Silent-Dripper/silent-dripper-electrical/media/oshpark-preview-back.png

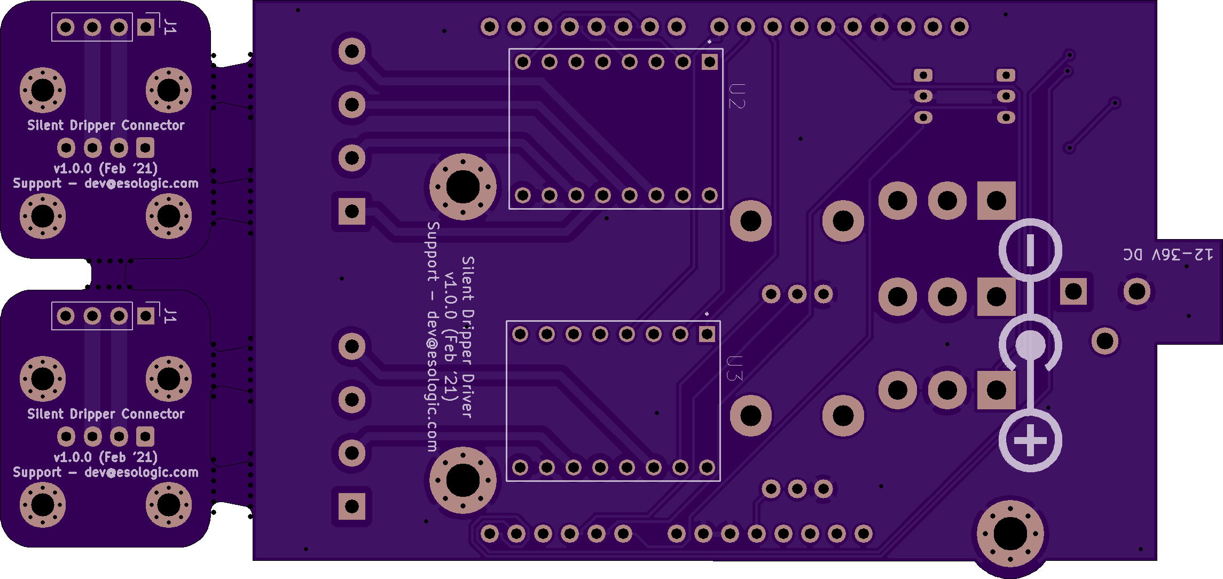
media/oshpark-preview-back.png
