Silent-Dripper/silent-dripper-electrical/media/oshpark-preview-front.png

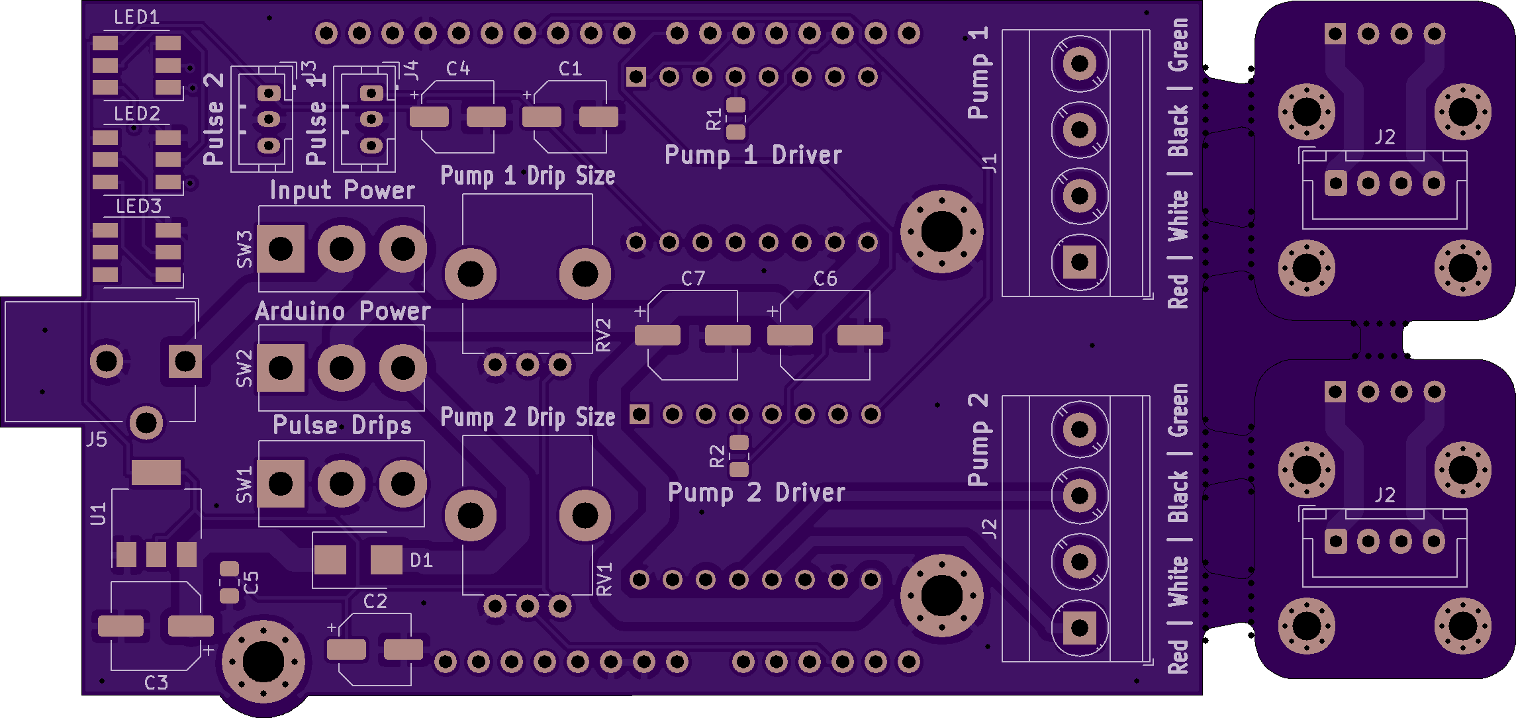
media/oshpark-preview-front.png
