Silent-Dripper/silent-dripper-electrical/panelized/dripper-gerbers/dripper-gerbers_Combined_Bottom.png

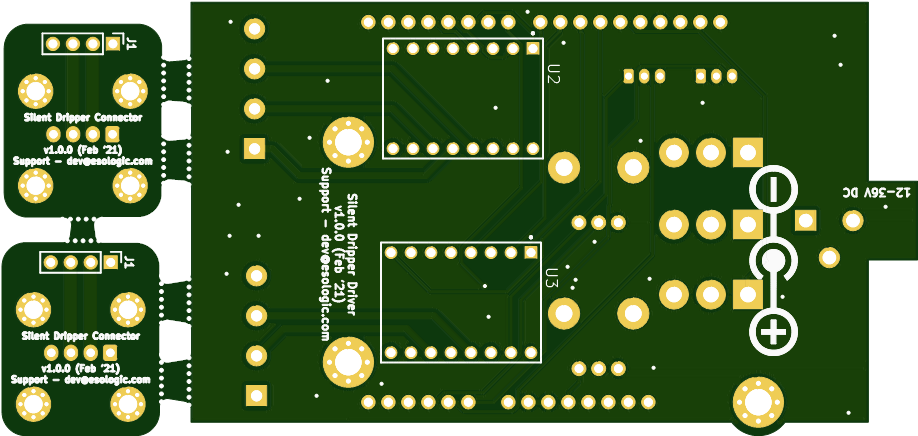
panelized/dripper-gerbers/dripper-gerbers_Combined_Bottom.png
