Silent-Dripper/silent-dripper-electrical/panelized/dripper-gerbers/dripper-gerbers_Combined_Top.png

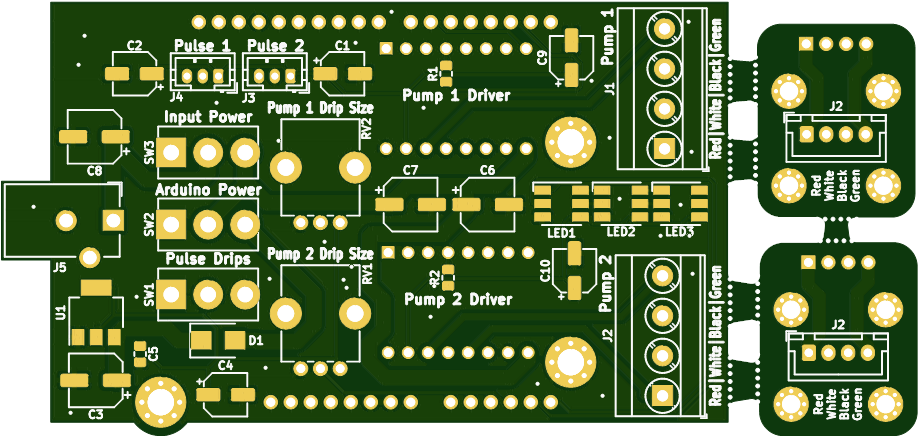
panelized/dripper-gerbers/dripper-gerbers_Combined_Top.png
