Silent-Dripper/silent-dripper-electrical/connector/connector-pcb-component-locations.DXF

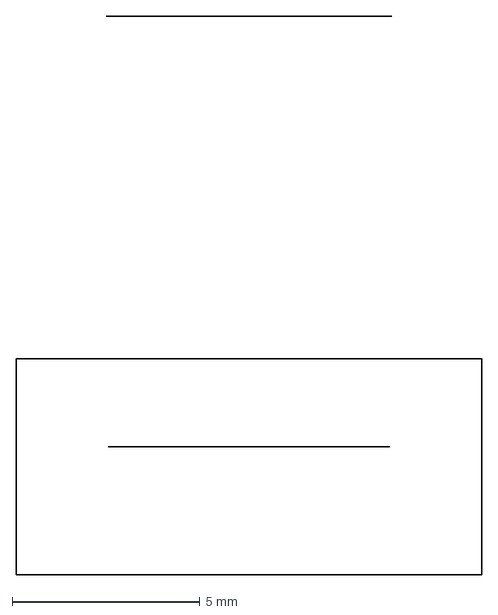
[picture p5: CAD file, 2021-11-12]
connector/connector-pcb-component-locations.DXF
12.4 x 14.9 mm
