Silent-Dripper/silent-dripper-electrical/connector/connector-pcb-outside-edge.DXF

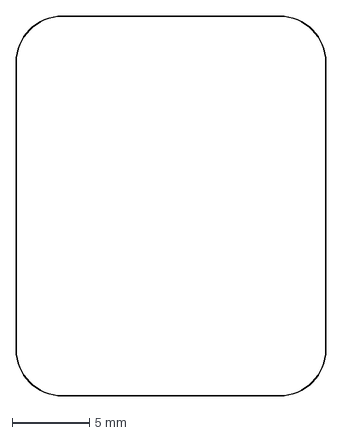
[picture p6: CAD file, 2021-11-12]
connector/connector-pcb-outside-edge.DXF
20.0 x 24.5 mm
