Silent-Dripper/silent-dripper-electrical/connector/connector-pcb-hole-locations.DXF

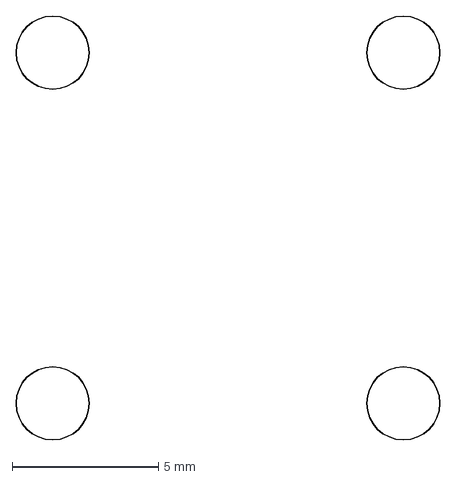
[picture p7: CAD file, 2021-11-12]
connector/connector-pcb-hole-locations.DXF
14.5 x 14.5 mm
