Silent-Dripper/silent-dripper-electrical/connector/connector-fit-check.pdf

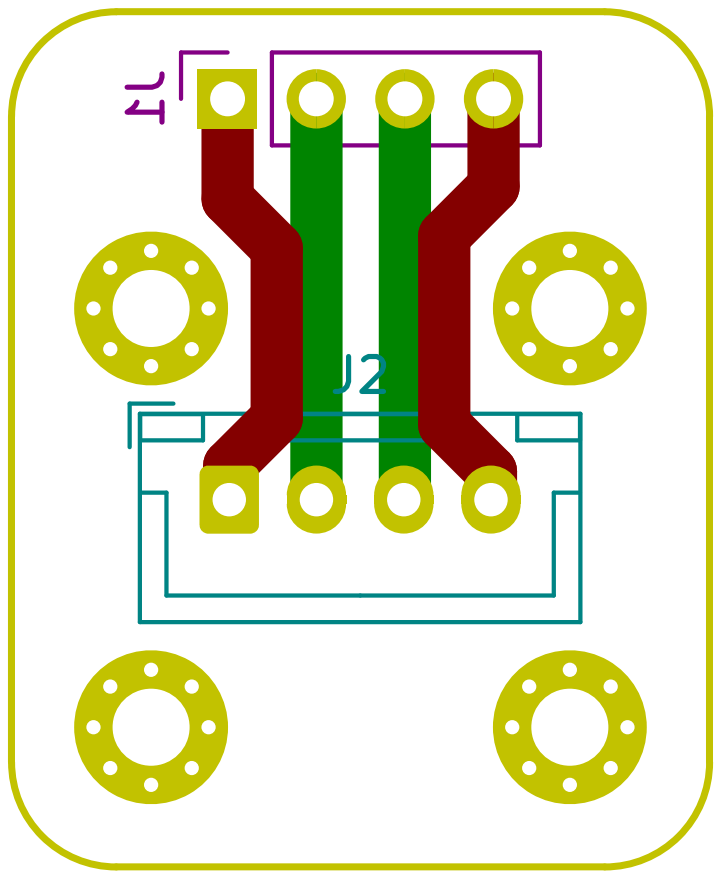
[picture p8: page 1]
