Silent-Dripper/silent-dripper-electrical/driver/driver-fit-check-back.pdf

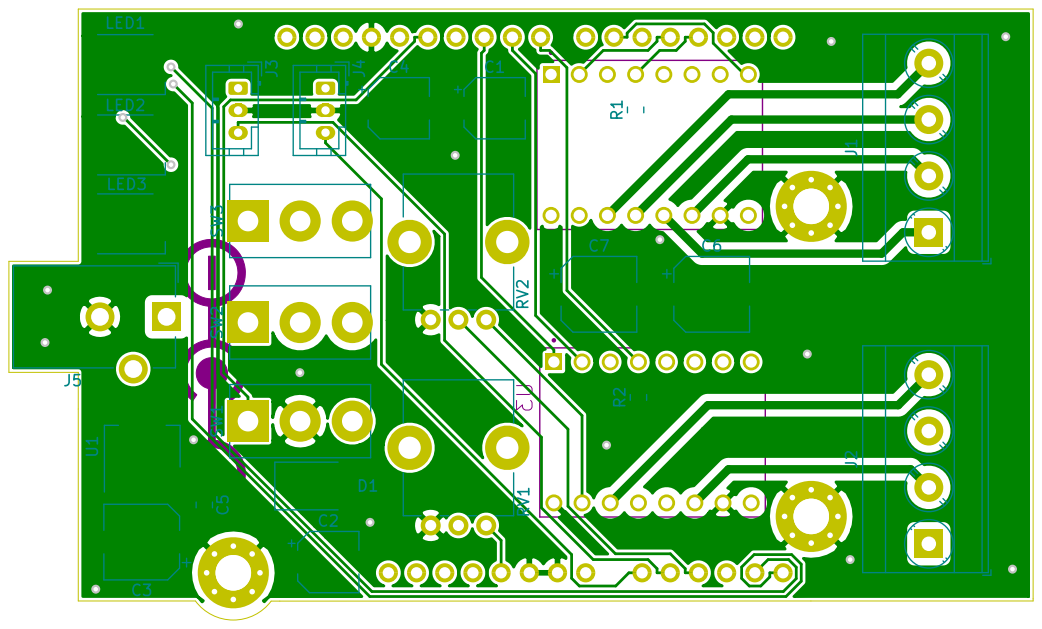
[picture p9: page 1]
