Silent-Dripper/silent-dripper-electrical/driver/driver-fit-check-front.pdf

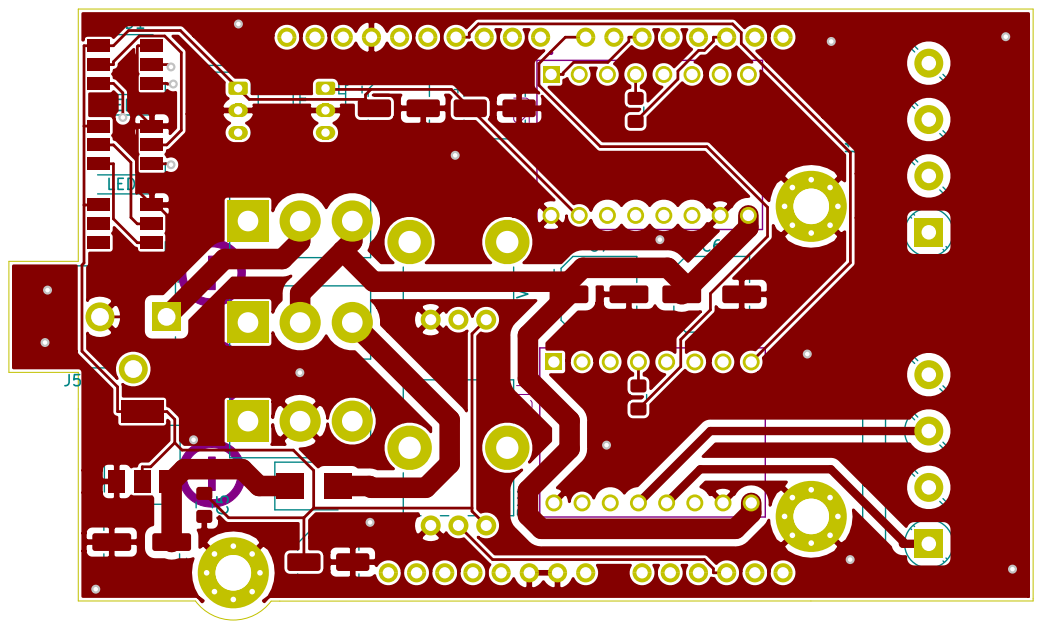
[picture p10: page 1]
