Silent-Dripper/silent-dripper-electrical/driver/driver-fit-check-no-copper.pdf

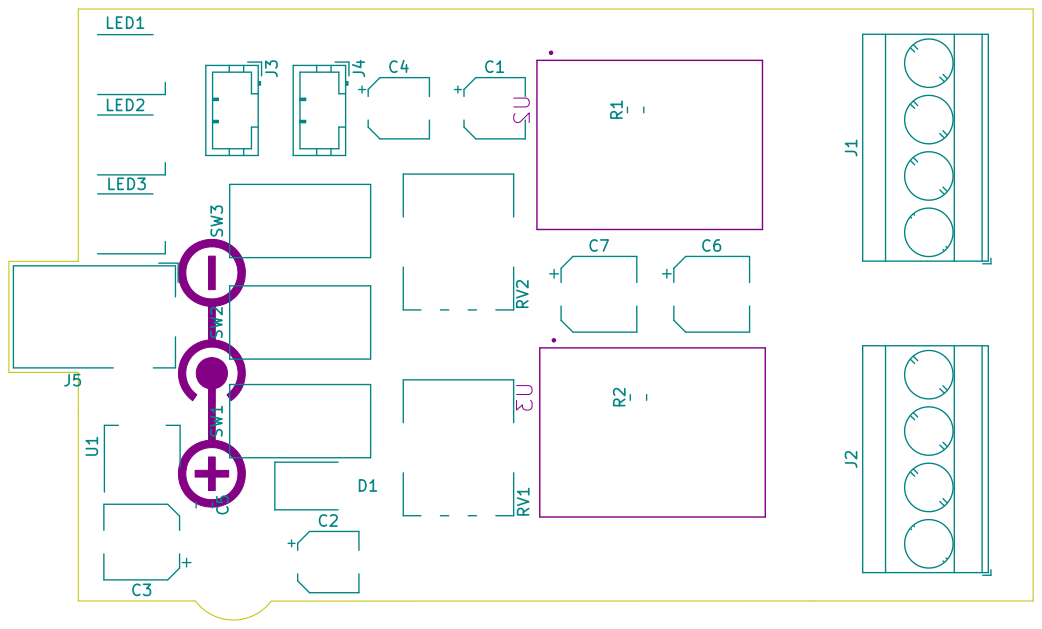
[picture p11: page 1]
