Silent-Dripper/silent-dripper-electrical/(list of files, drawings)

Other design files:
driver/driver.dsn
