Silent-Dripper/silent-dripper-electrical/(commit log)

2021-02-04 Schematic for driver mostly done
    [driver.kicad_pcb, driver.sch, tmc_circuit.sch]
2021-02-07 Added connector project, mostly laid out driver.
    [connector.kicad_pcb, connector.sch, driver.kicad_pcb, tmc_circuit.sch]
2021-02-08 Added prod footprint locations and PCB edges. Also very happy with driver component placement.
    [connector.kicad_pcb, driver.kicad_pcb]
2021-02-09 Added BOM, re-organized things a bit
    [bom.csv, connector-pcb-component-locations.DXF, connector-pcb-hole-locations.DXF, connector-pcb-outside-edge.DXF, connector.kicad_pcb, driver.csv, driver.kicad_pcb, driver.sch]
2021-02-12 Routed both boards, happy. Hopefully the traces are thick enough, used an only calculator given max rated draw of the TMCs
    [connector.kicad_pcb, driver.kicad_pcb, driver.sch, tmc_circuit.sch]
2021-02-14 Driver routing ready for fit check
    [driver.kicad_pcb]
2021-02-14 Fit test passed, panelized boards. Ready to order soon
    [combined.drl, combined.gbl, combined.gbo, combined.gbs, combined.gm1, combined.gtl, combined.gto, combined.gts]
2021-02-14 Noticed an error in the silkscreen and re-panelized
    [combined.drl, combined.gbl, combined.gbo, combined.gbs, combined.gm1, combined.gtl, combined.gto, combined.gts]
2021-02-15 Design is finished, ordering boards
    [combined.drl, combined.gbl, combined.gbo, combined.gbs, combined.gm1, combined.gtl, combined.gto, combined.gts]
2021-02-15 Updated BOM with final cap counts and symbol names
    [bom.csv, connector.sch, driver.csv]
2021-02-15 Added per board BOMs
    [connector_bom.csv, driver_bom.csv]
